yuntsebaryon/SLArpaasPressureAna/fig/TopPlate_Photo.jpg

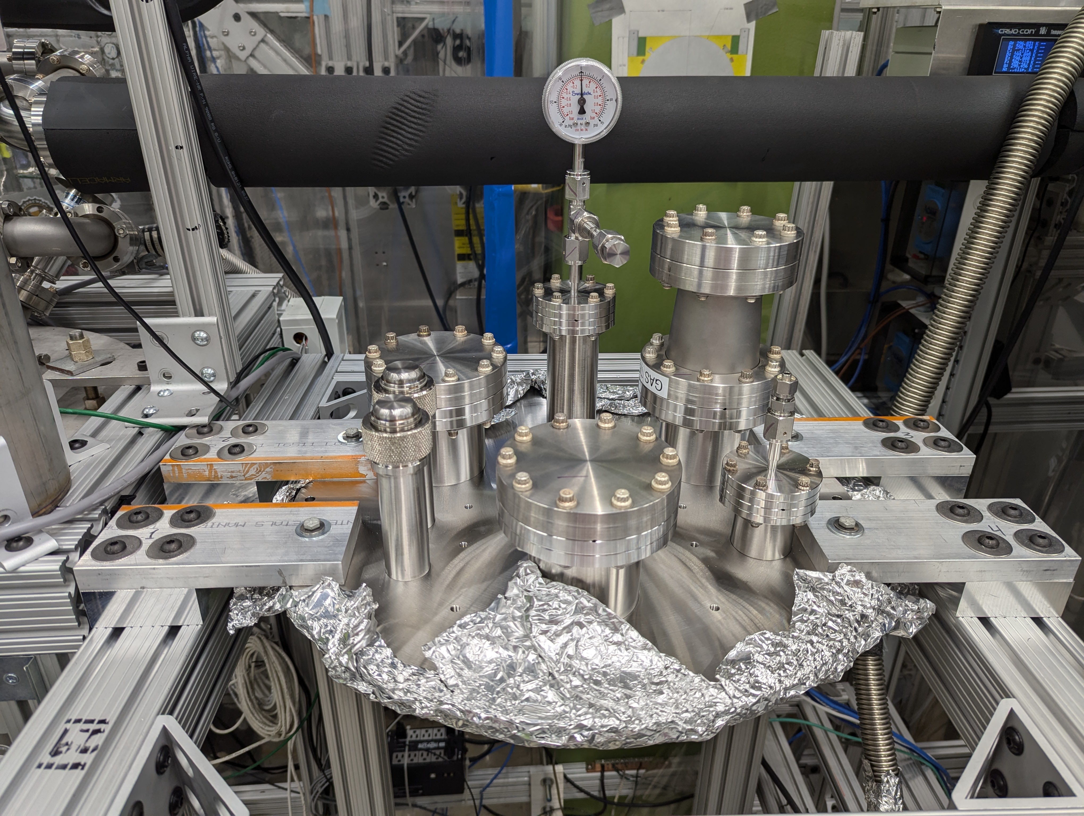
fig/TopPlate_Photo.jpg
