yuntsebaryon/SLArpaasPressureAna/table/ring_flange.tex

%-------------------------------------------------------------------
\begin{table}[h]
\begin{center}
\tabcolsep=10pt
\begin{tabular}{r|c|l|l}
\hline
\hline
Variable & Sym. & Value & Unit \\
\hline
Outside diameter of flange & $A$ & 18 & in \\
Inside diameter of flange & $B$ & 14 & in \\
Bolt‐circle diameter & $C$ & 17 & in \\
Outside diameter of gasket contact face & $G$ & 15.086 & in \\
Flange thickness & $t$ & 0.63 & in \\
Number of bolts & $n$ & 8 & n/a \\
Internal design pressure & $P$ & 15 & psig \\
gasket factor, obtain from Table 2-5.1 & $m$ & 0 & n/a \\
Nominal bolt diameter & $a$ & 0.313 & in \\

% \hline
% Variables obtained in this appendix & & & \\
% \hline
% Total hydrostatic end force & $H$ & 2679.84 & lb \\
% Total joint-contact surface compression load & $H_P$ & 0 & lb \\
% Minimum required bolt load for the operating conditions & $W_{m1}$ & 2924.64 & lb \\
\hline
\hline
\end{tabular}
\caption{Flange parameters of the dewar based on the Cryofab drawing
and analysis.  Note that the flange thickness refers to the flange
of the dewar.  The nominal bolt diameter, $a$, is taken from 5/16"-18 bolts.}
\label{table:ring_flange}
\end{center}
\end{table}
%-------------------------------------------------------------------
