yuntsebaryon/SLArpaasPressureAna/table/discharge_summary.tex

%-------------------------------------------------------------------
\begin{table}[h]
\begin{center}
\tabcolsep=10pt
\begin{tabular}{m{8cm}|c|c}
\hline
\hline
Failure mode & Heat load (W) & Ar Flow (scfm) \\
\hline
Fail to open the venting valve of SLArPAAS I at the initial LAr filling & -- & 115.3 \\
Loss of cooling power & 1000 & 7.82 \\
Loss of vacuum insulation of the SLArPAAS I vessel: air & 148.85 & 1.17 \\
Loss of vacuum insulation of the SLArPAAS I vessel: Ar & 100.16 & 0.78 \\
\hline
\hline
\end{tabular}
\caption{Summary of the failure scenarios and the resulting heat load, Ar flow.
Note that these numbers are overestimated and can be considered as the upper bounds.}
\label{table:discharge_summary}
\end{center}
\end{table}
%-------------------------------------------------------------------
