yuntsebaryon/SLArpaasPressureAna/table/opening_dist.tex

%-------------------------------------------------------------------
\begin{table}[h]
\begin{center}
\tabcolsep=10pt
\begin{tabular}{m{2cm}|m{2cm}|l|m{2cm}|m{2.5cm}}
\hline
\hline
Diameter of Opening 1 (in) & 
Diameter of Opening 2 (in) & Distance (in) & 
Required Distance (in) & 
Reinforcement Required? \\
\hline
3 & 3 & 8.113, 8.113, 9 & 6 & No \\
1.7 & 1.7 & 7.601 & 3.4 & No \\
1.2 & 1.2 & 2.253 & 2.4 & Yes (1) UG-39(b)(2) \\
3 & 1.2 & 3.536, 4.977 & 4.2 & Yes (2) UG-39(b)(2) \\
3 & 1.7 & 4.562 & 4.7 & Yes (3) UG-39 (b)(2) \\
3 & 1.7 & 4.707, 5.78 & 4.7 & No \\
\hline
\hline
\end{tabular}
\caption{Distances between the openings on the top plate of
SLArPAAS I, and the reinforcement requirements.}
\label{table:opening_dist}
\end{center}
\end{table}
%-------------------------------------------------------------------
