yuntsebaryon/SLArpaasPressureAna/tex/app_mawp.tex

\section{Dewar Maximal Allowable Working Pressure}
\label{app:mawp_statement}

Document stating the maximum allowable working pressure
of the Cryofab CF 1424-F dewar is shown in Fig.~\ref{fig:mawp}.

\begin{figure}[h]
    \centering
    
    \caption{Cryofab quote stating the maximum allowable working
    pressure of the CF 1424-F dewar.}
    \label{fig:mawp}
\end{figure}
