yuntsebaryon/SLArpaasPressureAna/tex/app_topplate_drawing.tex

\section{Drawing of the Top Plate}
\label{app:top_plate_drawing}

The drawing and the photo of the top plate are shown in Fig.~\ref{fig:top_plate}
and \ref{fig:top_plate_photo}, respectively.

\begin{figure}[h]
    \centering
    
    \caption{Drawing of the top plate.}
    \label{fig:top_plate}
\end{figure}

\begin{figure}[h]
    \centering
    
    \caption{Photo of the top plate.}
    \label{fig:top_plate_photo}
\end{figure}
