yuntsebaryon/SLArpaasPressureAna/tex/app_photo.tex

\section{Photos of the Main Dewar and Top Plate}
\label{app:photos}
