yuntsebaryon/SLArpaasPressureAna/tex/registration.tex

\section{New Pressure System Registration}
\label{sec:registration}

The \textbf{New Pressure System Registration Form} has been prepared 
and is included in a separate file in this package.
