yuntsebaryon/SLArpaasPressureAna/table/blind_flange.tex

%-------------------------------------------------------------------
\begin{table}[h]
\begin{center}
\tabcolsep=10pt
\begin{tabular}{>{\raggedleft}m{5cm}|c|l|l|m{5.5cm}}
\hline
\hline
Variable & & Value & Unit & Reference \\
\hline
Diameter & $d$ & 18 & in & design drawing \\
A factor depending upon the method of attachment of head, shell dimensions, 
and other items as listed in (d) below & $C$ & 
0.3 & n/a & 0.25 based on sketch (p) of Fig. UG-34, but Cryofab uses 0.3 \\
Internal design pressure & $P$ & 15 & psig & 10\% beyond the Cryofab spec. \\
Maximum allowable stress value & $S$ & 20000 & psi & Table ULT-23 at 0, 100, 150$^{\circ}$F \\
Joint efficiency & $E$ & 1 & n/a & Table UW-12 \\
\hline
Minumum Required Thickness & $t$ & 0.27 & in & UG-34 (c)(2)(1) \\
\hline
SLArPAAS Top Plate Thickness & n/a & 0.5 & in & design drawing \\
\hline
Pressure Sustained by SLArPAAS Top Plate & n/a & 51.44 & psi & UG-34 (c)(2)(1) with $t=0.5$~in \\
\hline
\hline
\end{tabular}
\caption{Blind flange parameters to determine the minimum required thickness.}
\label{table:blind_flange}
\end{center}
\end{table}
%-------------------------------------------------------------------
