yuntsebaryon/SLArpaasPressureAna/table/dewar.tex

%-------------------------------------------------------------------
\begin{table}[h]
\begin{center}
\tabcolsep=10pt
\begin{tabular}{>{\raggedleft}m{4.5cm}|c|l|l|m{5.5cm}}
\hline
\hline
Variable &  & Value & Unit & Reference \\
\hline
Internal design pressure & $P$ & 12.5 & psig & 10\% beyond the Cryofab spec. \\
Maximum allowable stress value & $S$ & 20000 & psi & Table ULT-23 at 0, 100, 150$^{\circ}$F \\
Joint efficiency & $E$ & 0.7 & n/a & Cryofab pressure analysis \\
Inside radius of the shell course & $R$ & 7 & in & Cryofab \\
Inside spherical or crown radius & $L$ & 14 & in & Cryofab pressure analysis uses 
the inner diameter \\
Shell thickness & $t$ & 0.024 & in & Cryofab pressure analysis \\
Bottom thickness & $t_b$ & 0.048 & in & Cryofab pressure analysis \\
\hline
Longitudinal stress & n/a & 96.13 & psi &  UG-27(c)(2)(2) \\
Torespherical bottom stress & n/a & 46.08 & psi & UG-32(d)(2) \\
\hline
\hline
\end{tabular}
\caption{Dewar parameters to determine the longitudinal shell stress
and the torispherical bottom stress.}
\label{table:dewar}
\end{center}
\end{table}
%-------------------------------------------------------------------
