yuntsebaryon/SLArpaasPressureAna/table/opening_reinforcement.tex

%-------------------------------------------------------------------
\begin{table}[h]
\begin{center}
\tabcolsep=10pt
\begin{tabular}{l|m{2cm}|m{2cm}|m{1.4cm}|l|l|m{2.2cm}}
\hline
\hline
No. & Diameter of Opening 1 (in) & 
Diameter of Opening 2 (in) & 
Distance $s$ (in) &
$A$ (in$^2$) & $R$ (in$^2$) & Reinforcement Fulfiled? \\
\hline
(1) & 1.2 & 1.2 & 2.253 & 0.135 & 0.289575 & Yes \\
(2) & 3 & 1.2 & 3.536 & 0.23625 & 0.3949   & Yes \\
(3) & 3 & 1.7 & 4.562 & 0.264375 & 0.6083  & Yes \\
\hline
\hline
\end{tabular}
\caption{Calculation of required reinforcements.  The numbering 
corresponds to Table~\ref{table:opening_dist}. }
\label{table:opening_reinforcement}
\end{center}
\end{table}
%-------------------------------------------------------------------
