yuntsebaryon/SLArpaasPressureAna/tex/main.tex

\documentclass[letterpaper,11pt]{article}

\usepackage[margin=1in]{geometry}
\usepackage[titletoc,title]{appendix}
\usepackage{amsmath}
\usepackage{amssymb}
\usepackage{amsthm}
\usepackage{amscd}
\usepackage{amsfonts}
\usepackage{graphicx}%
\usepackage{fancyhdr}
\usepackage{color}
\usepackage{sectsty}
\usepackage[colorlinks=true,linkcolor=black,anchorcolor=black,citecolor=black,filecolor=black,menucolor=black,runcolor=black,urlcolor=black]{hyperref}
\usepackage{siunitx}
\usepackage{cleveref}
% \usepackage{natbib}
% \usepackage{biblatex} %Imports biblatex package
% \addbibresource{PDR.bib} %Import the bibliography file
\usepackage{csquotes}
\usepackage{array}
\usepackage{tablefootnote}
\usepackage[]{todonotes}

%-----------------------------------------------

\hyphenation{LArTPC}
\hyphenation{LArTPCs}

\newcommand{\tslarpaas}      {t_{\text{SLArPAAS I}}}
\newcommand{\davg}           {d_{\text{avg}}}

%---------------------------------------------

\renewcommand{\arraystretch}{1.2}

%-----------------------------------------------

\pagestyle{fancy}\lhead{}
\setlength{\parindent}{0em}

\title{SLArPAAS I Engineering Note}
\author{Yun-Tse Tsai}

%-----------------------------------------------

\begin{document}

\maketitle
\tableofcontents

%------------------------------------------------
% Main text
% -----------------------------------------------
\input{tex/introduction}
\input{tex/system}
\input{tex/location}
\input{tex/pressure_cal}
\input{tex/discharge_rate}
\input{tex/buckling}
\input{tex/pressure_test}
\input{tex/registration}
\input{tex/hazard_ana}

%------------------------------------------------
% Appendix
% -----------------------------------------------
\clearpage
\begin{appendices}

% \input{tex/app_pid}
% \clearpage    
\input{tex/app_dewar_drawing}

\clearpage
\input{tex/app_mawp}

\clearpage
\input{tex/app_topplate_drawing}

% \clearpage
% \input{tex/app_photo}

% \clearpage
% \input{tex/app_partlist}

\clearpage
\input{tex/app_dewar_pressure_ana}

\clearpage
\input{tex/app_topplate}

\clearpage
\input{tex/app_ringflange}

\clearpage
\input{tex/app_discharge}

\clearpage
\input{tex/app_dewar_buckling}

\clearpage
\input{tex/app_manufacturer}

% \clearpage
% \input{tex/app_hazard_ana}
% \input{tex/app_procedure}
% \input{tex/app_registration}
% \input{tex/app_pressure_test}

\end{appendices}

\end{document}
