yuntsebaryon/SLArpaasPressureAna/tex/app_dewar_drawing.tex

\section{Drawing of the Dewar}
\label{app:dewar_drawing}

The maximum allowable working pressure of the Cryofab CF 1424-F dewar,
10~psig,
is stated in the Cryofab drawing, Fig.~\ref{fig:dewar}.

% ----------------------------------------------------------
\begin{figure}[h]
    \centering
    
    \caption{Cryofab drawing of the CF 1424-F dewar.}
    \label{fig:dewar}
\end{figure}
% ----------------------------------------------------------
