yuntsebaryon/SLArpaasPressureAna/fig/IR2Layout.pdf

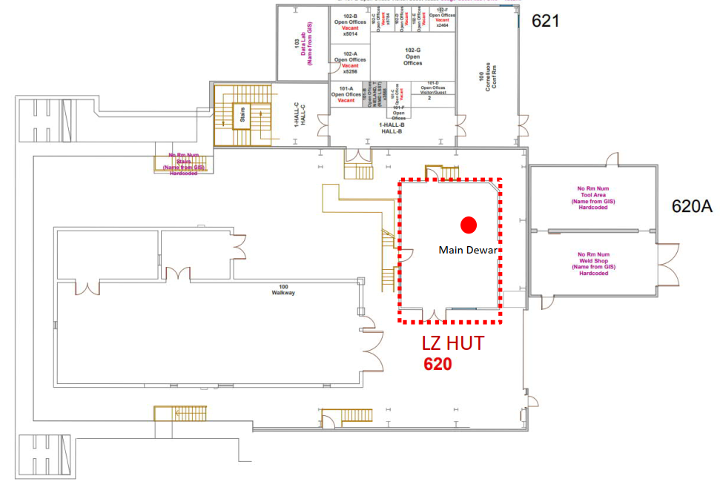
[picture p2: page 1]
