yuntsebaryon/SLArpaasPressureAna/fig/MDC_BurstDisc.png

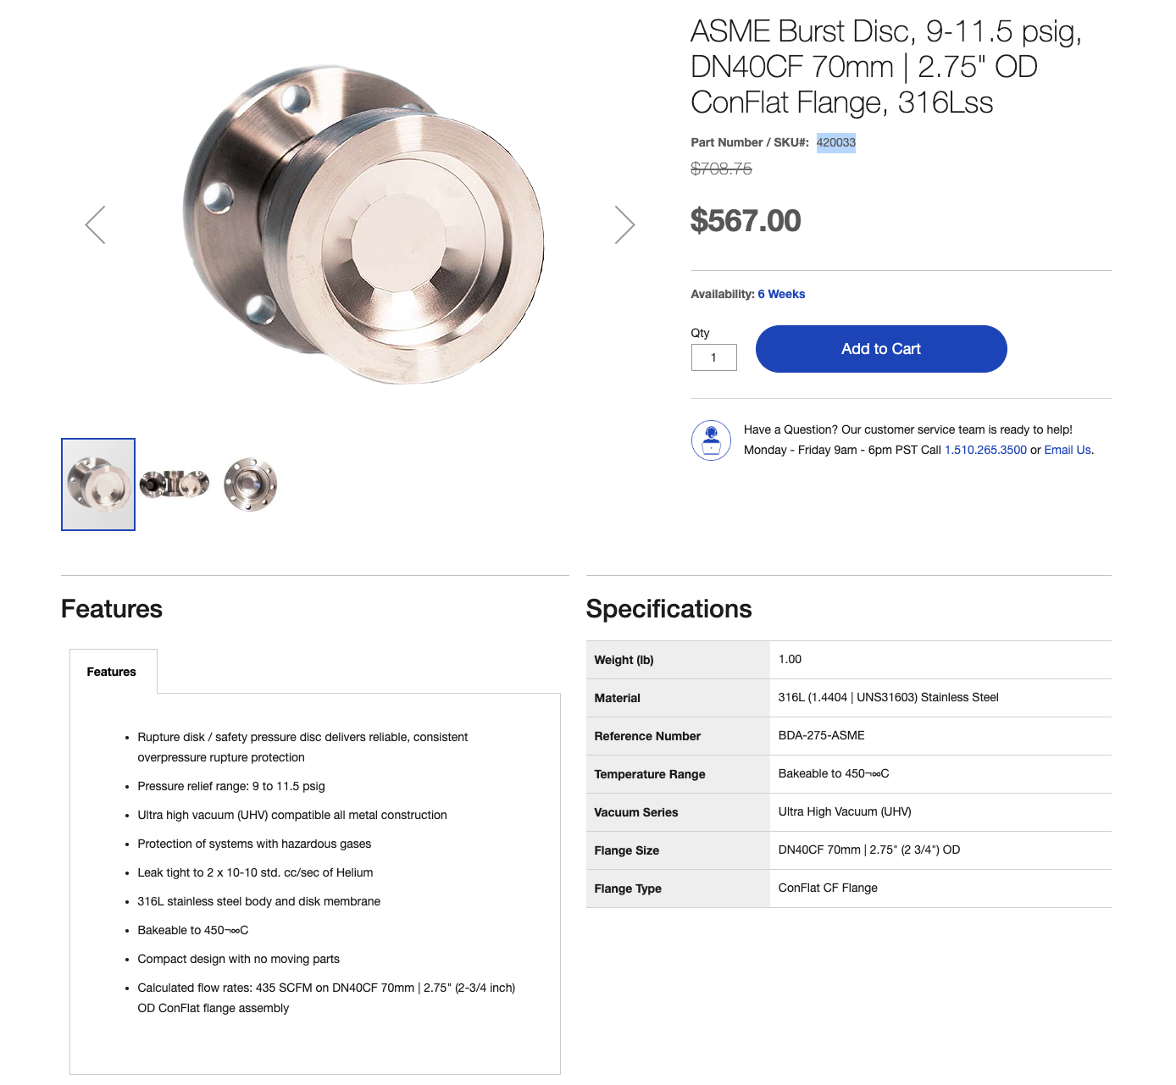
fig/MDC_BurstDisc.png
