yuntsebaryon/SLArpaasPressureAna/tex/app_partlist.tex

\section{System Partial Part List}
\label{app:partlist}
