yuntsebaryon/SLArpaasPressureAna/(list of files, cad)

Other CAD files:
drawing/PressureTestPID.dwg
