yuntsebaryon/SLArpaasPressureAna/form/gauge_calibration_cert.pdf

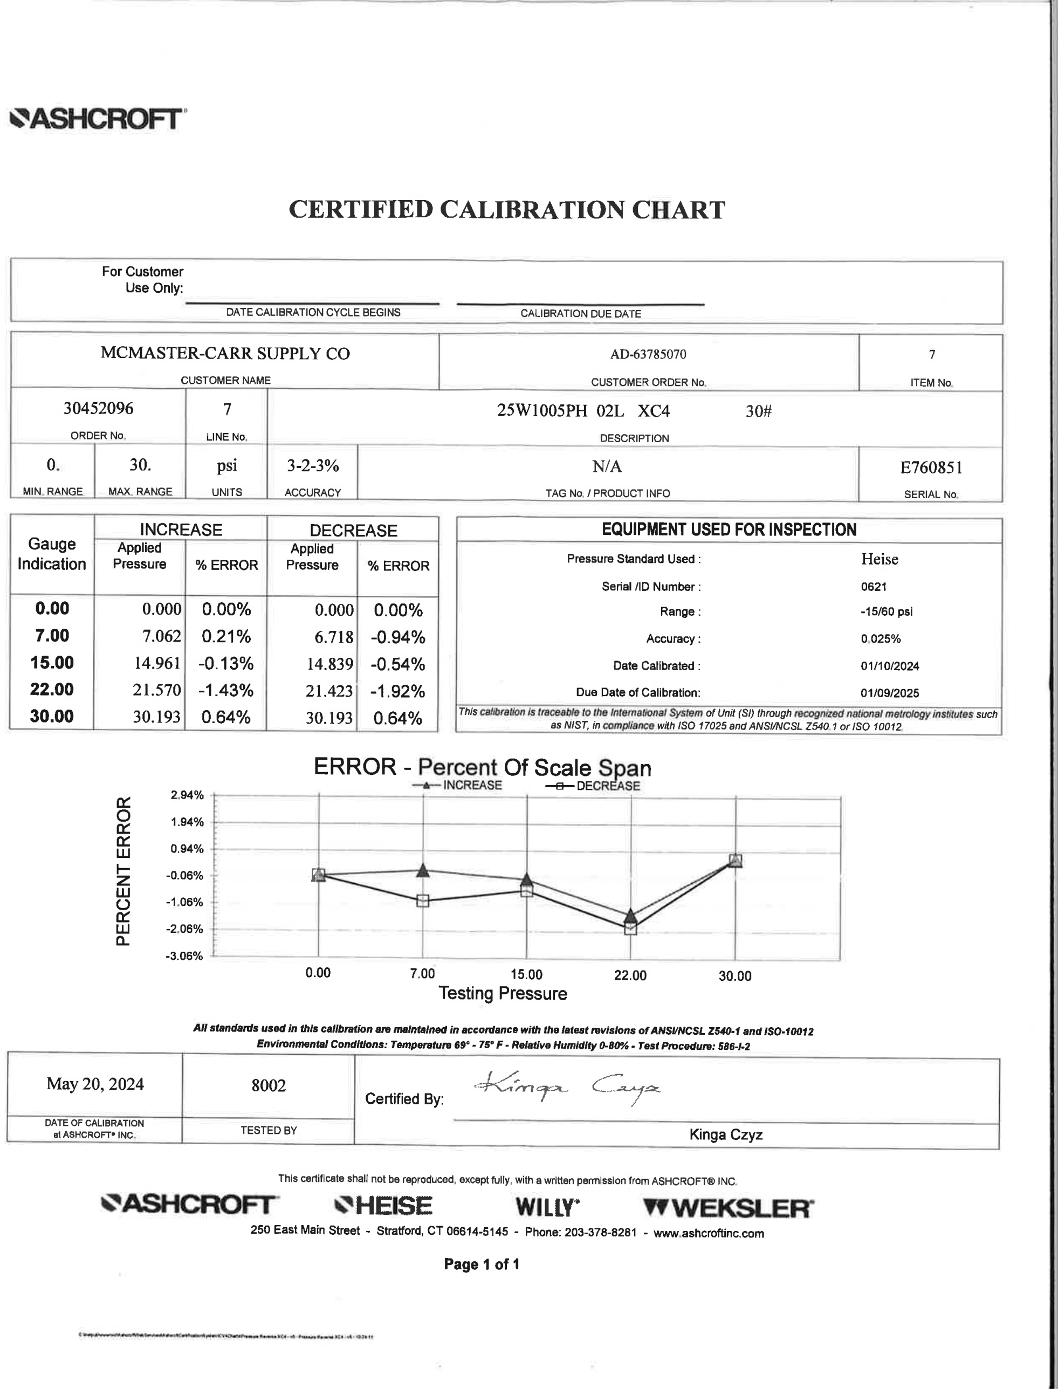
[picture p4: page 1]
