yuntsebaryon/SLArpaasPressureAna/tex/hazard_ana.tex

\section{Process Hazard Analysis}
\label{sec:hazard_ana}

The research team and ESH Coordinator convened a Process Hazard Analysis (PHA) 
Meeting on July 8th, 2024. 
Attendees included Yun-Tse Tsai, Miriam Moore, Tomasz Biesiadzinski, Richard Delacruz,
Tom Shutt, Boyd Bowdish, Manuel Gonzales, Steffen Luitz, Leonardo Peres, and Shoma Kodama.\\

The P\&ID including the cryogenic vessel, piping, and components was carefully reviewed 
during the meeting and various failure scenarios were discussed and documented in a table.\\

The actions required must be reviewed and accepted by Richard Delacruz, FPD ESH Coordinator, 
with concurrence by the department head, Hiro Tanaka, before the vessel and associated 
system is filled and operated.\\

The SLArPAAS I Hazard Analysis can be found in
\url{https://docs.google.com/spreadsheets/d/1sxUV8Ua3J8l6XIYgdW33Ia-IjVwUAQS-_h5lZe0bloU/edit?usp=sharing},
and is included as a spreadsheet in this package.
% The Action Item tab of the PHA shows the status of the action items identified.
