yuntsebaryon/SLArpaasPressureAna/tex/app_hazard_ana.tex

\section{SLArpaas Hazard Analysis}
\label{app:hazard_ana}

The SLArpaas hazard analysis can be found in 
\url{https://docs.google.com/spreadsheets/d/1sxUV8Ua3J8l6XIYgdW33Ia-IjVwUAQS-_h5lZe0bloU/edit?usp=sharing},
and is included as a spreadsheet in this package.
