yuntsebaryon/SLArpaasPressureAna/fig/PID_SLArchettoPAAS_v9.5_PressureTest.pdf

# TS LN tank

# (deck level)V34

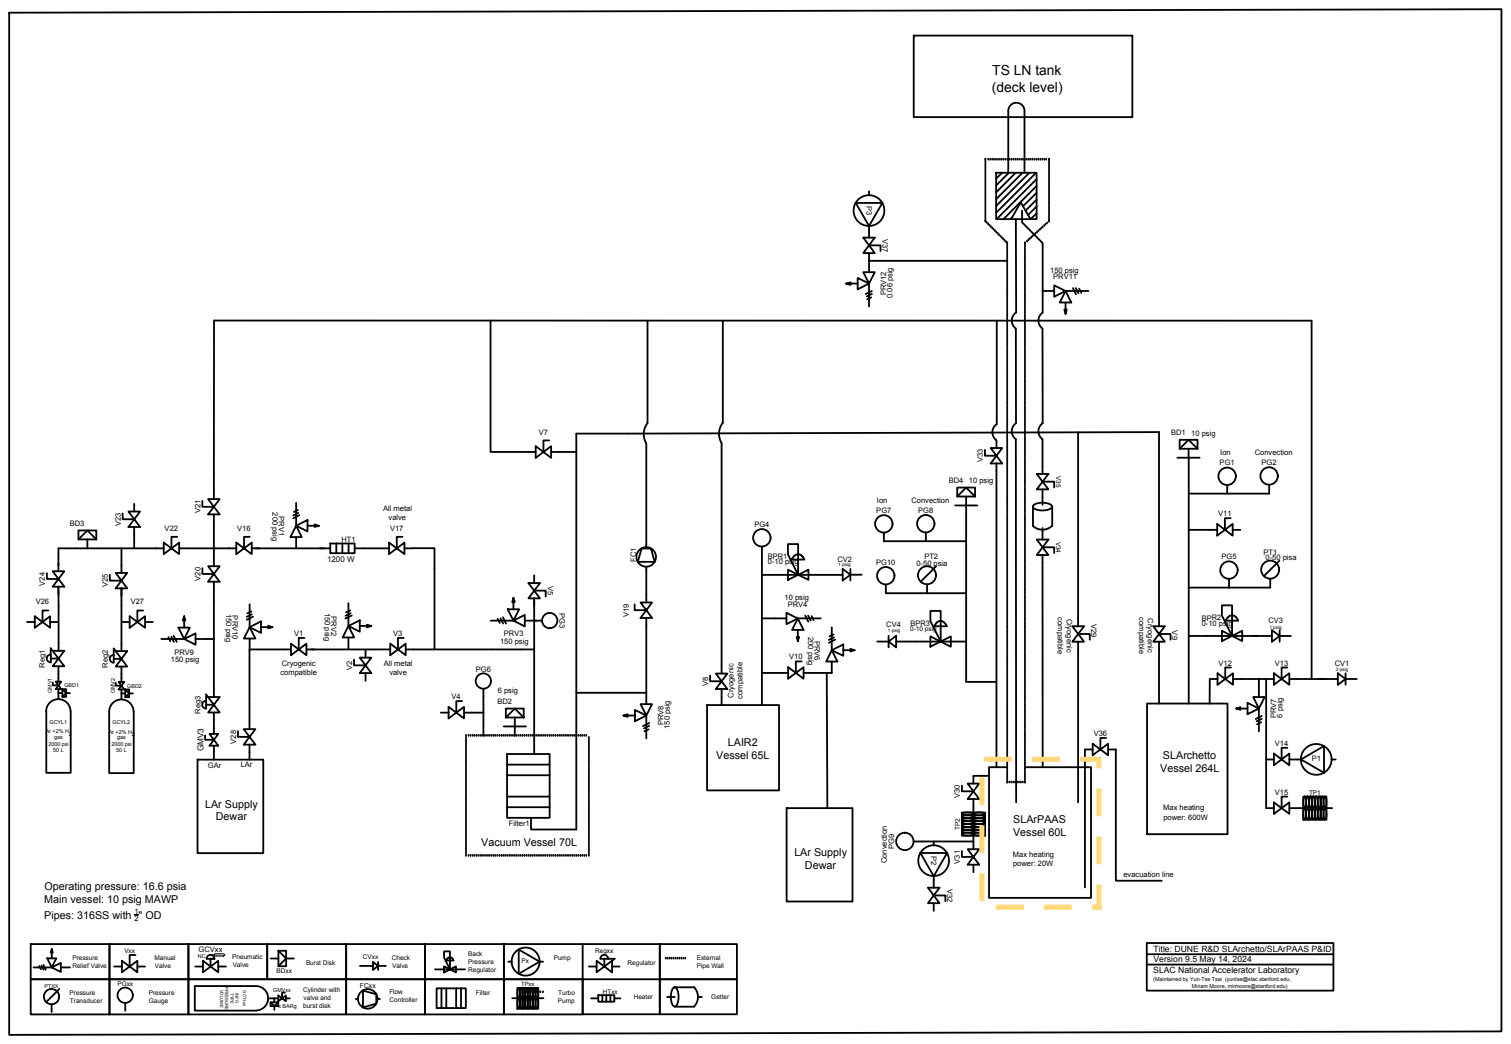
[picture p5: page 1]
Manual Valve; Pump; PTXX; Regxx; PGxx; Regulator; Pressure Transducer; Pressure Gauge; BDxx; Burst Disk; Vxx; TPxx; Turbo Pump; Check Valve; CVxx; Reg1; Filter1; PRV2; 150 psig; PRV3 150 psig; Pressure Relief Valve; Back Pressure Regulator; Filter; LAIR2 Vessel 65L; LAr Supply Dewar; Cryogenic; compatible; All metal valve; Cryogenic compatible; Heater HTxx; PRV1; 200 psig; FCxx; Flow; Controller; GMVxx; TYPE; INFO; PRESSURE; VOLUME; GCYLxx; x BARg; Cylinder with valve and burst disk; GMV2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

Operating pressure: 16.6 psia
Main vessel: 10 psig MAWP
Pipes: 316SS with ¹

Title: DUNE R&D SLArchetto/SLArPAAS P&ID
Version 9.5 May 14, 2024
SLAC National Accelerator Laboratory
(Maintained by Yun-Tse Tsai (yuntse@slac.stanford.edu,

Miriam Moore, mirmoore@stanford.edu)
