yuntsebaryon/SLArpaasPressureAna/fig/PID_SLArchettoPAAS_v9.5.pdf

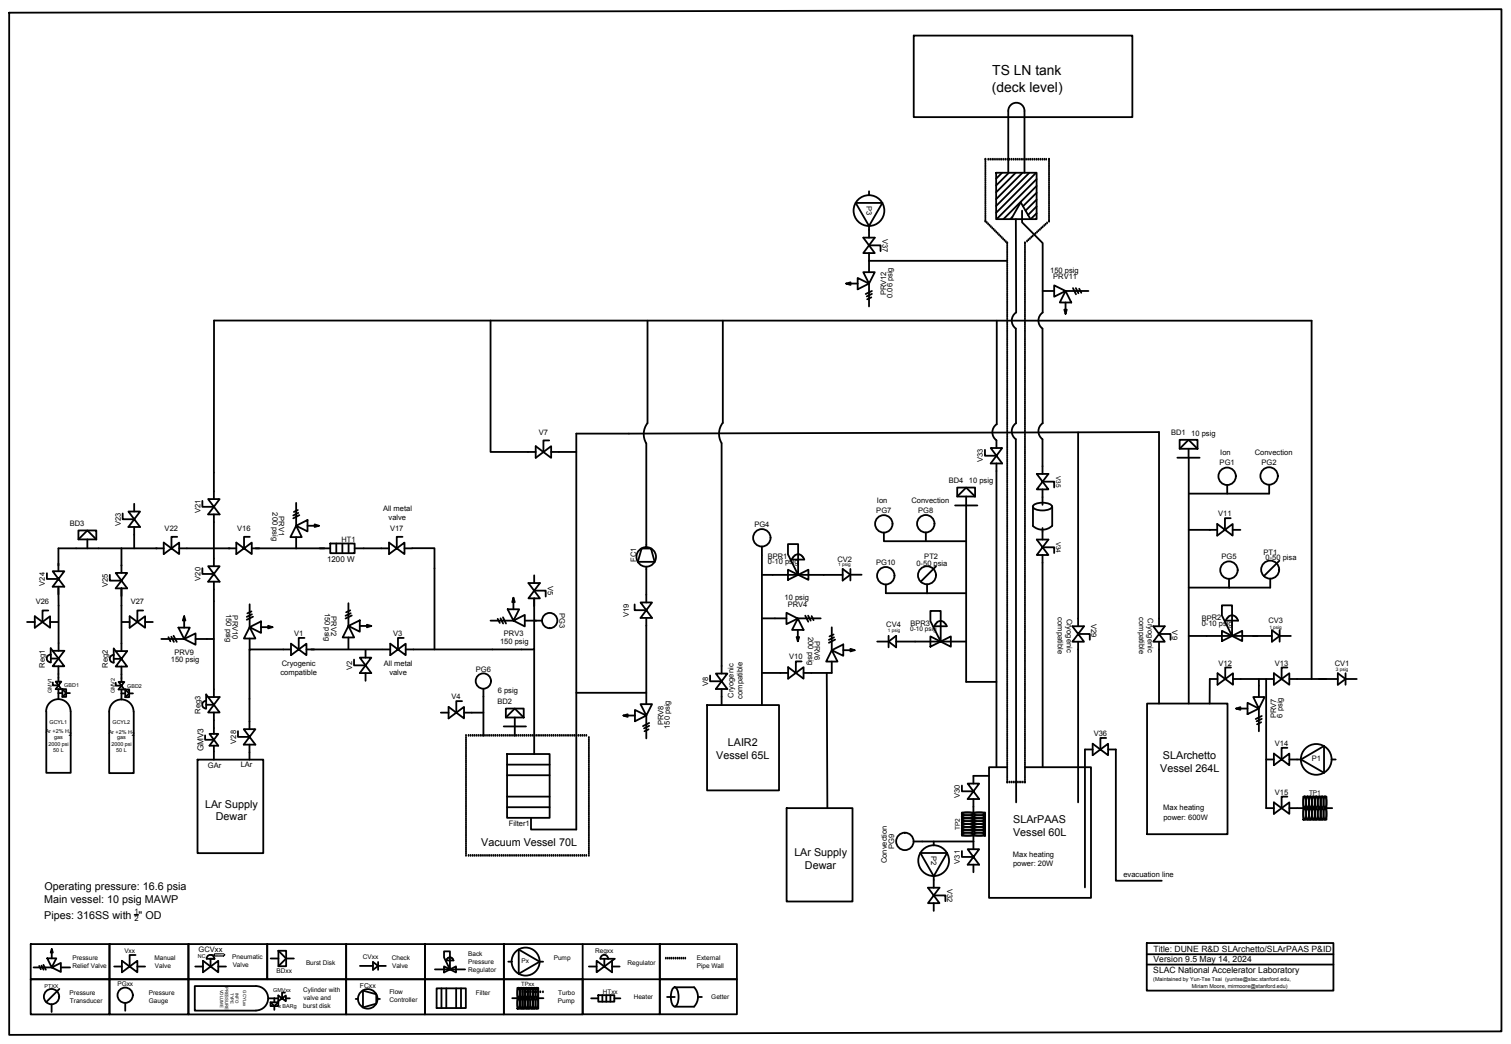
[picture p6: page 1]
Manual Valve; Pump PTXX; Regxx PGxx; Regulator Pressure Transducer; Pressure Gauge; BDxx; Burst Disk; Px Vxx; TPxx; Turbo Pump Check Valve CVxx; V5 PG3 V1 V3 Reg1; V8 Filter1; 200 psig; 150 psig; GMV3 Reg3 PRV9 150 psig; V30 SLArPAAS Vessel 60L; V34 Getter; V35 V36 evacuation line; compatible Cryogenic; P3 V37 PRV12; 0.06 psig

PG9 Convection External Pipe Wall TS LN tank (deck level)

compatible Cryogenic PRV11 150 psig GAr LAr

150 psig PRV10 P1 CV3 1 psig PG5 PT1 0-50 pisa V11 BD1 V12 BPR2 0-10 psig SLArchetto Vessel 264L Max heating power: 600W 10 psig V14 V13 PRV7

6 psig V15 TP1 CV1 3 psig PG1 PG2 Ion Convection V33

P2V31 TP2 BD4 10 psig PG7 PG8 Ion Convection CV4 1 psig PG10 PT2 0-50 psia BPR3 0-10 psig

GMV1 Ar +2% H2 gas 2000 psi 50 L GCYL1GBD1 Reg2 BD3 V23 CV2 1 psig PG4 V10 BPR1 0-10 psig PRV4 10 psig GCVxx NC GSCVxx Pneumatic Valve Title: DUNE R&D SLArchetto/SLArPAAS P&ID Version 9.5 May 14, 2024 SLAC National Accelerator Laboratory (Maintained by Yun-Tse Tsai (yuntse@slac.stanford.edu, Miriam Moore, mirmoore@stanford.edu)

compatibleAll metal valve Cryogenic compatible Heater HTxx V17 HT1 1200 W All metal valve PRV1

200 psig V26 V27 LAr Supply Dewar

150 psigPRV3 150 psig Pressure Relief Valve Back Pressure Regulator Filter LAIR2 Vessel 65L LAr Supply Dewar Operating pressure: 16.6 psia Main vessel: 10 psig MAWP Pipes: 316SS with 12" OD

GMV2 Ar +2% H2 gas 2000 psi 50 L GCYL2GBD2 BD2 V4 PG6 6 psig Vacuum Vessel 70L

V2 FCxx Flow Controller GMVxx TYPE

V32 Max heating power: 20W

VOLUME GCYLxx x BARg Cylinder with valve and burst disk
