yuntsebaryon/SLArpaasPressureAna/drawing/PressureTestPID-Model.pdf

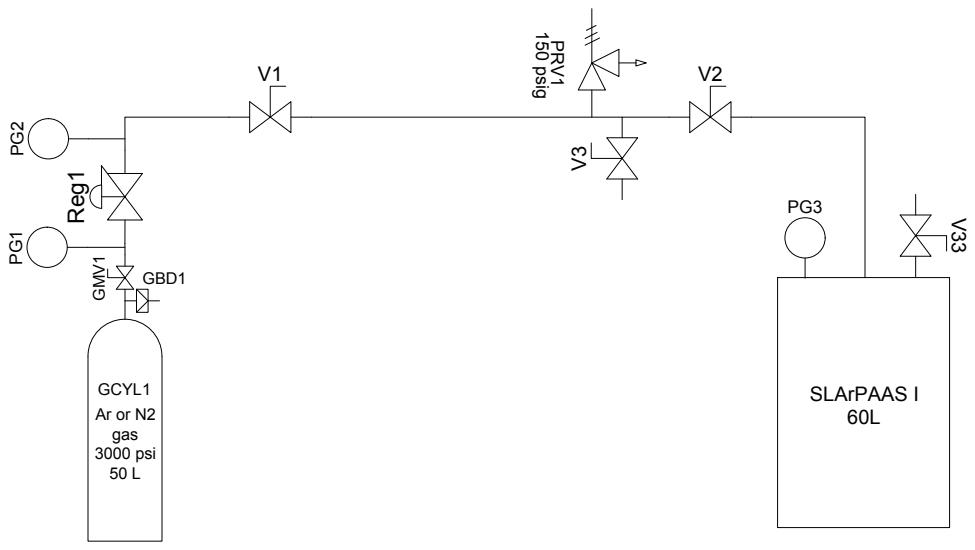
[picture p7: page 1]
150 psig PG3; PG2 PG1 SLArPAAS I 60L

GMV1 Ar or N2 gas 3000 psi 50 L GCYL1GBD1
