yuntsebaryon/SLArpaasPressureAna/fig/DewarDrawing.pdf

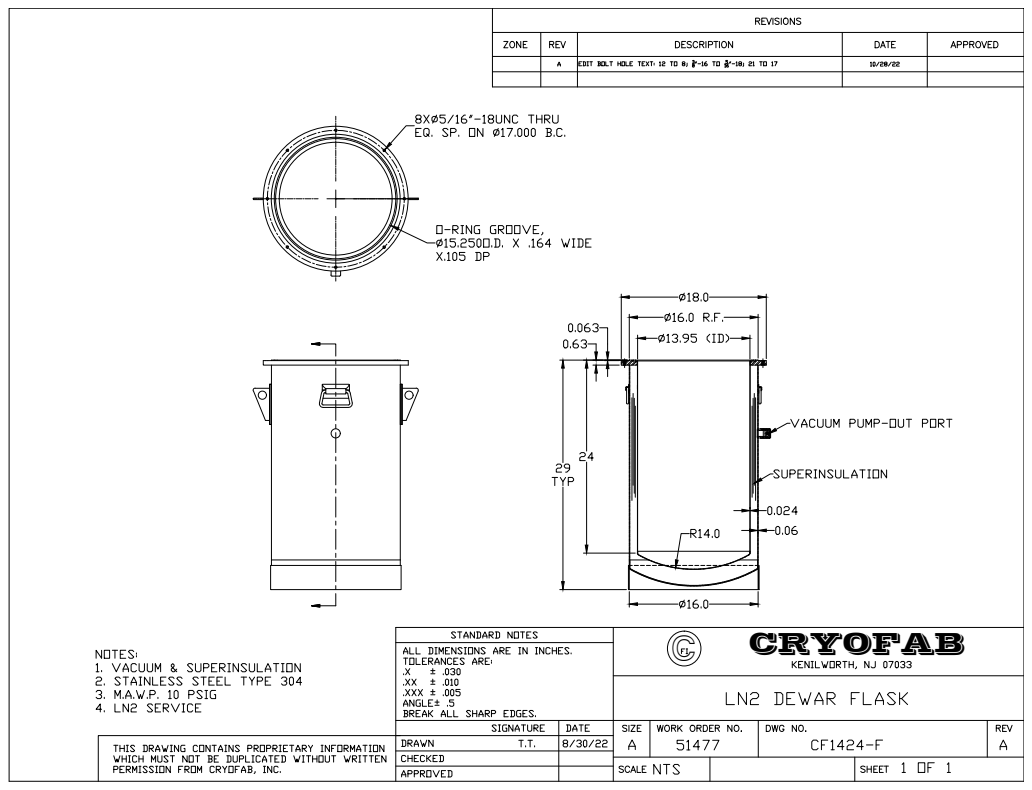
[picture p8: page 1]
C CRYOFAB
