yuntsebaryon/SLArpaasPressureAna/(commit log)

2023-11-07 all the top flange pressure calculations for now
2023-11-09 complete the top plate calculations, add more appendices
2024-06-11 add new appendix for the buckling analysis
2024-06-11 buckling analysis
2024-06-11 add Cryofab xslx files
    [Collapsing Pressure Calculation CF1424-F SN 859-860.xlsx, Dewar Design Pressure CF1424-F SN 859-860.xlsx, Flange Design Pressure CF1424-F SN 859-860.xlsx]
2024-06-12 remove cryofab excel files
    [Collapsing Pressure Calculation CF1424-F SN 859-860.xlsx, Dewar Design Pressure CF1424-F SN 859-860.xlsx, Flange Design Pressure CF1424-F SN 859-860.xlsx]
2024-06-12 add a pressure calculation
2024-06-27 calculate the discharge capacity
2024-06-27 burst disc and BPR information, PID
2024-06-27 heat load calculation... not finished
2024-06-27 top plate photo
2024-08-20 manufacturer information for the pressure relief devices
2024-08-20 update the pressure test plan
2024-08-20 P&ID for pressure test
    [PressureTestPID.dwg]
2024-08-20 emphasize the pressure test boundary
2024-08-21 calibration certificate of the pressure gauge used in the pressure test
2024-08-21 add the calibration date
2024-08-21 add the calibration certificate
